MichaelEngstrom/drumming-robot-masters-thesis/media/images/Perkowski_web.jpg

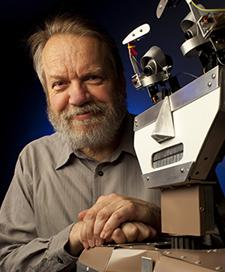
media/images/Perkowski_web.jpg
