MichaelEngstrom/drumming-robot-masters-thesis/media/images/RobotDrum.png

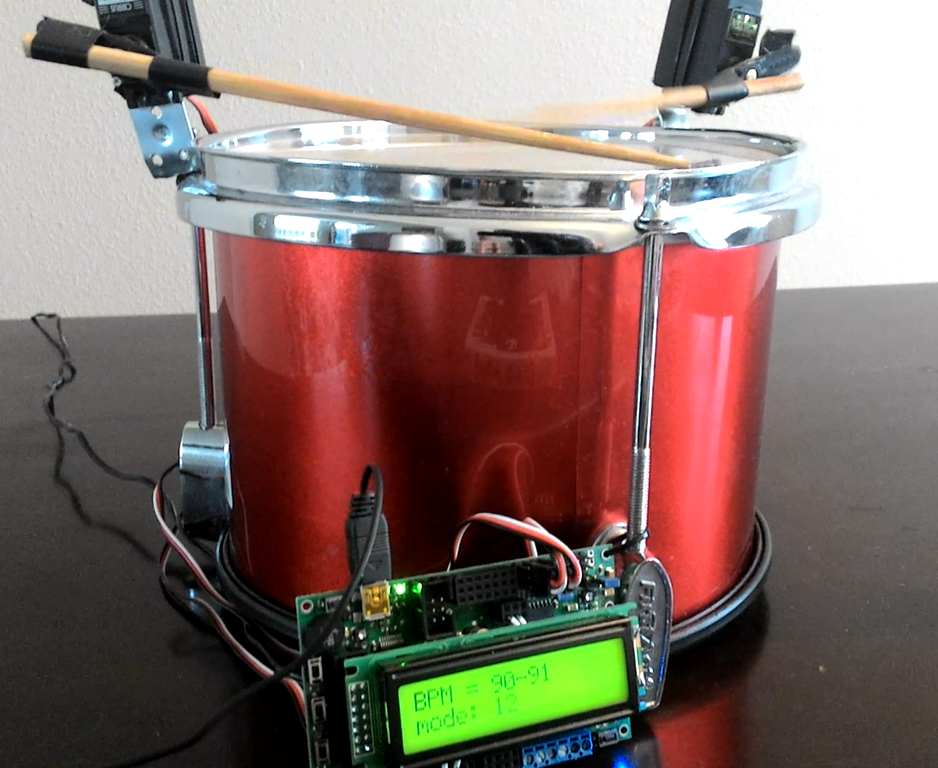
media/images/RobotDrum.png
