MichaelEngstrom/drumming-robot-masters-thesis/README.md

# masters-thesis
Thesis paper and supporting documents, videos, etcetera
