MichaelEngstrom/drumming-robot-masters-thesis/media/The Drumming Robot.pptx

## The Drumming Robot

Michael Engstrom
~
ECE 579 – Winter 2013

## Adding to ‘DIM’ Robot

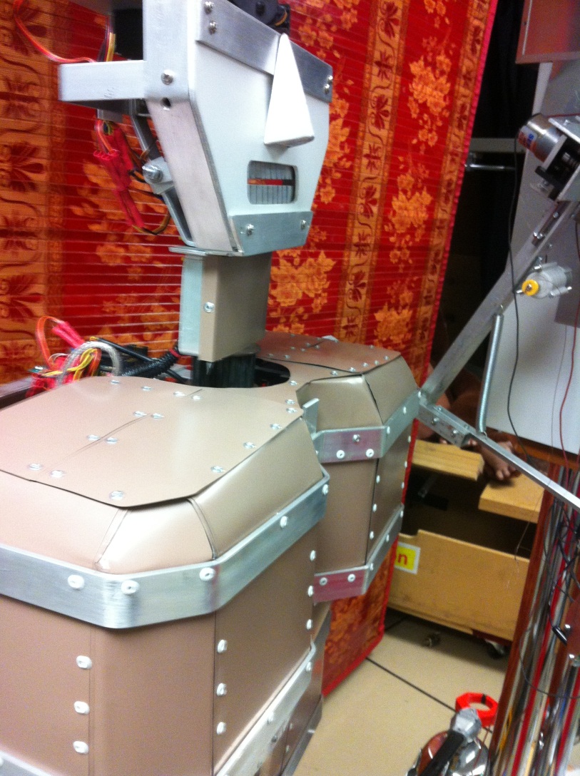
[picture p3: figure]

## Project Idea

- Design a robot that will play drums in rhythm to an audio source which is detected in the environment
- A robot control board will move servos to make arms and legs pound drums to a beat
- An input device will detect the audio, extract the beat, and send the information to the robot controller

## Project Phases

- Mechanical design of robot
  - Arms and legs to beat drums
  - Interface to control software
- Software
  - Input of audio source
  - Beat detection
  - Output to robot controller

## Mechanical Design

- Add limbs to the DIM robot (as seen in the Robot Theater window)
- Use servos to move limbs
- A Pololu ‘Orangutan SVP’ robot controller will handle the servo movement

## The Pololu Orangutan SVP Servo Controller

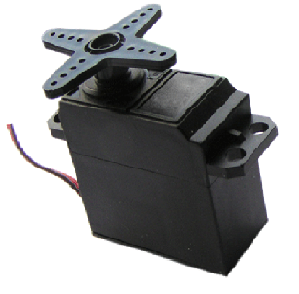
[picture p4: figure]

## Orangutan SVP from Pololu

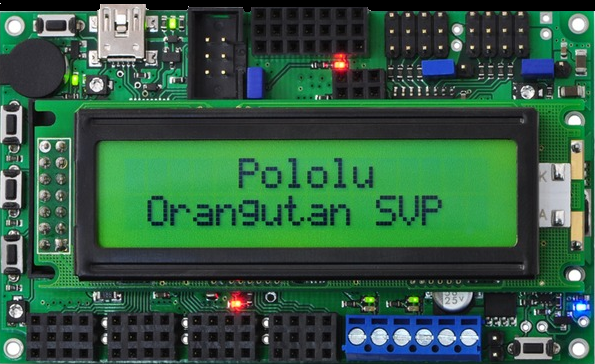
[picture p5: figure]

## Orangutan Specifications

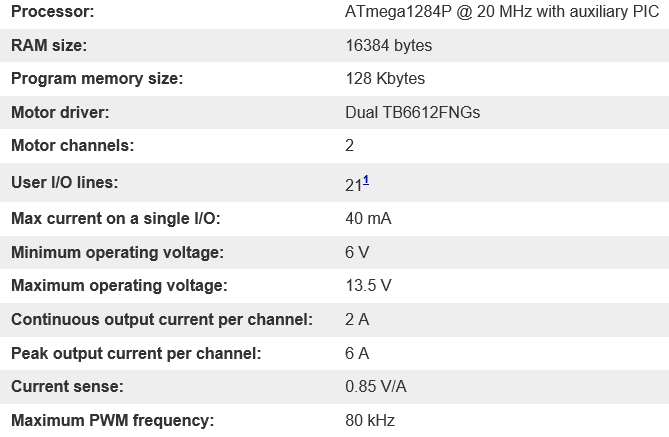
[picture p6: figure]

## DIM’s Torso and Arm

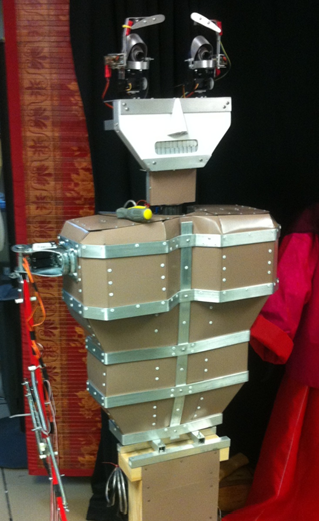
[picture p7: figure]

## Software Design

- Beat Detection Algorithm
  - Rice University Project
  - Based on an MIT design
  - Uses MATLAB to extract beat information from audio input
- Serial interface to Orangutan board
  - BPM and control information

## Beat Detection

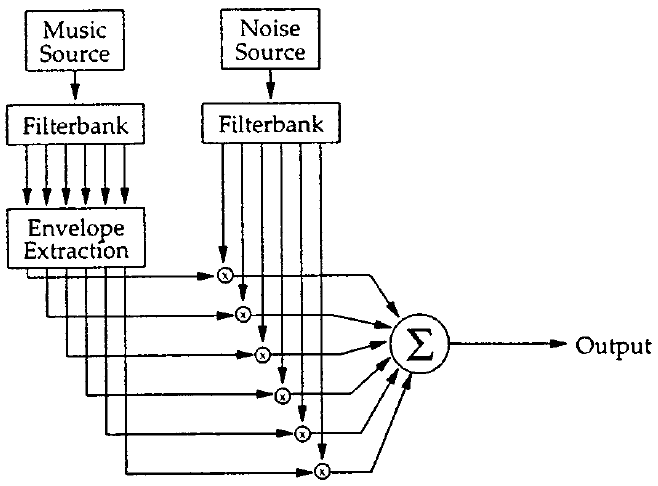
[picture p8: figure]

## PSYCHOACOUSTIC SIMPLIFICATION

- Simplification of Noise sources

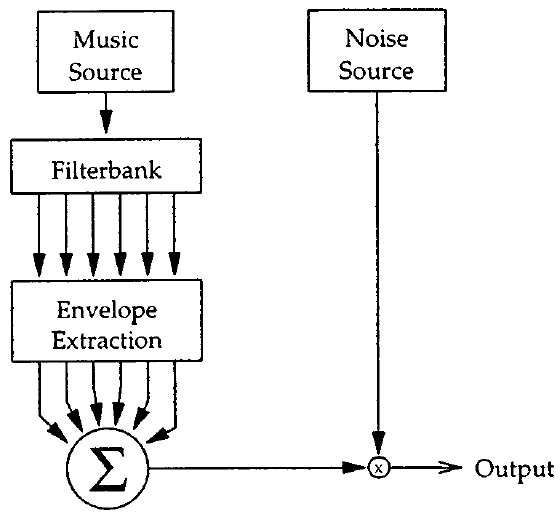
[picture p9: figure]

## Slide 13

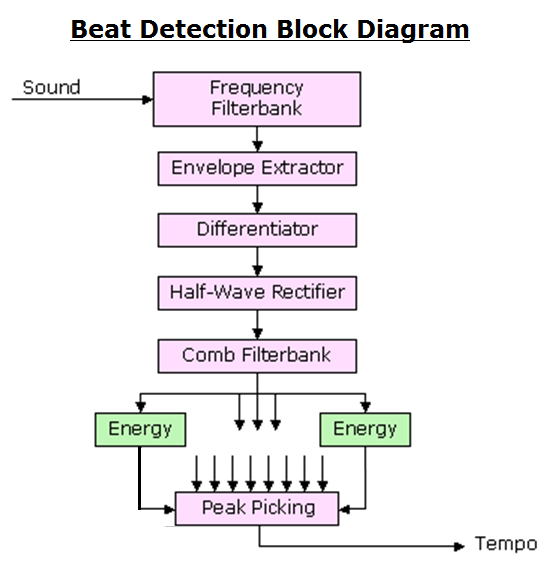
[picture p10: figure]

## Beat Detection Algorithm

- Step 1 – Frequency Filterbank
  - Split audio file into several frequency ranges
    - Similar instrument ranges can inhibit the detection of the beat
  - Allows for different instruments to be detected
    - 0-200Hz, 200-400Hz, 400-800Hz, 800-1600Hz, 1600-3200Hz

## Beat Detection Algorithm

- Step 1 – Frequency Filterbank
- Each filter is implemented using a sixth-order elliptic filter
  - 3 dB of ripple in the passband
  - 40 dB of rejection in the stopband.

## Beat Detection Algorithm

- Step 1 – Frequency Filterbank

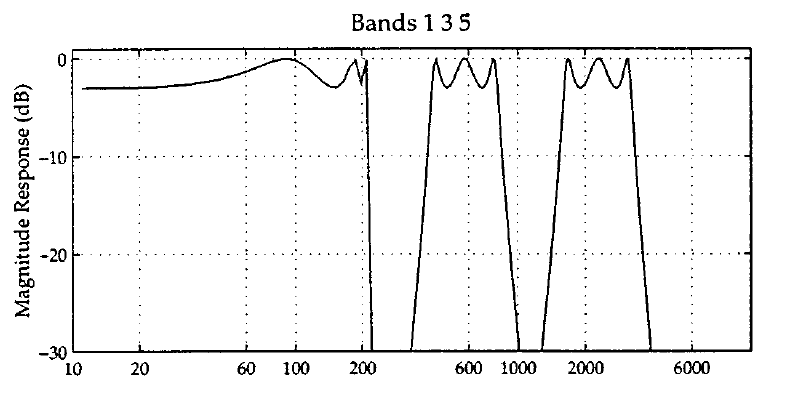
[picture p11: figure]

## Beat Detection Algorithm

- Step 1 – Frequency Filterbank

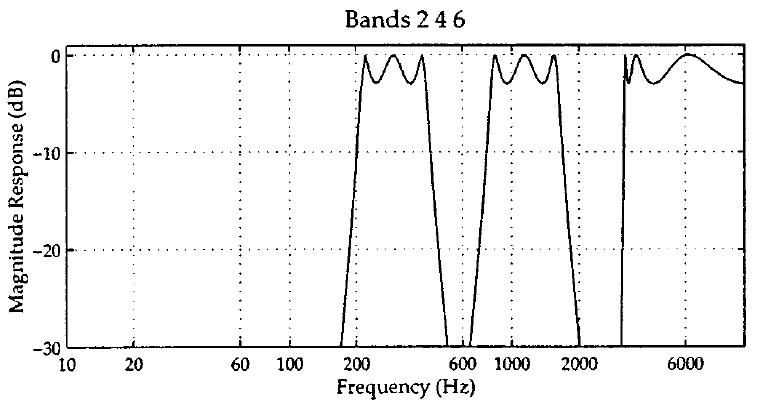
[picture p12: figure]

## Beat Detection Algorithm

- Step 2 – Envelope Smoothing
  - Low-Pass Filter each of the signal segments
    - Convert to Frequency Domain
    - Convolve and transform signal
  - Allows for detection of sudden changes in audio content

## Beat Detection Algorithm

- Step 2 – Envelope Smoothing: Example

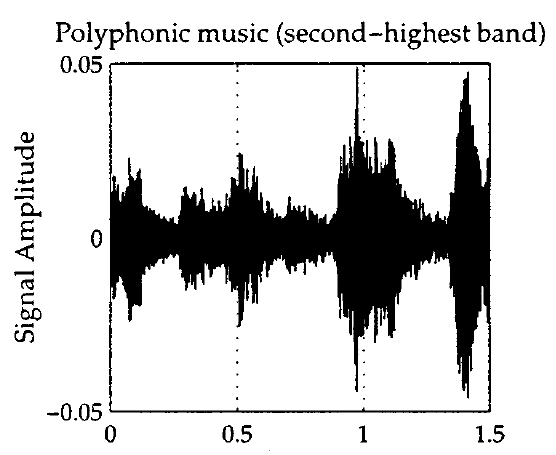
[picture p13: figure]

## Beat Detection Algorithm

- Step 2 – Envelope Smoothing: Example

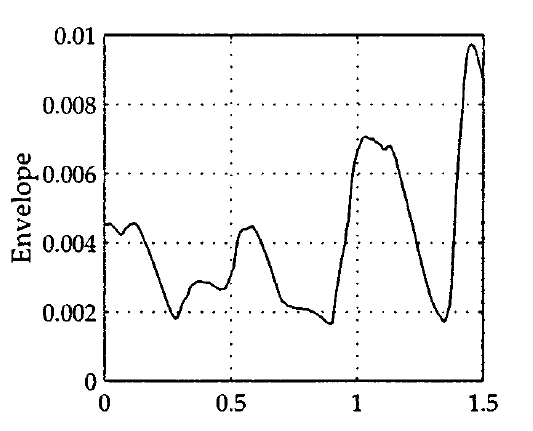
[picture p14: figure]

## Beat Detection Algorithm

- Step 3 – Differentiate signal
  - Accentuate when the sound changes
  - Corresponds to beats
- Step 4 – Rectify signal
  - Only see changes in sound
  - Signals ready to be analyzed

## Beat Detection Algorithm

- Step 5 – Comb Filter
  - Use various filters
  - Determine which has highest energy
  - Maximum value is the fundamental tempo

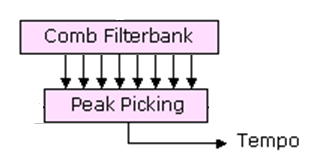
[picture p15: figure]

## Beat Detection Algorithm

- A Comb Filter is used to find tempo maxima
  - For delay T and gain α the magnitude response is
- Local maxima are wherever αe^(−jωT) is near 1 at the Tth roots of unity, expressed as

## Beat Detection Algorithm

- Stimulate a comb filter with delay T and gain α with a right-sided pulse train of height A and period k
- We get reinforcement (resonance) if T=k .
- Let x_t and y_t be the input and output signals at time t
- then y_t = αy_(t−T) + (1-α) x_t

## Beat Detection Algorithm

- Energy is higher at dominant tempos

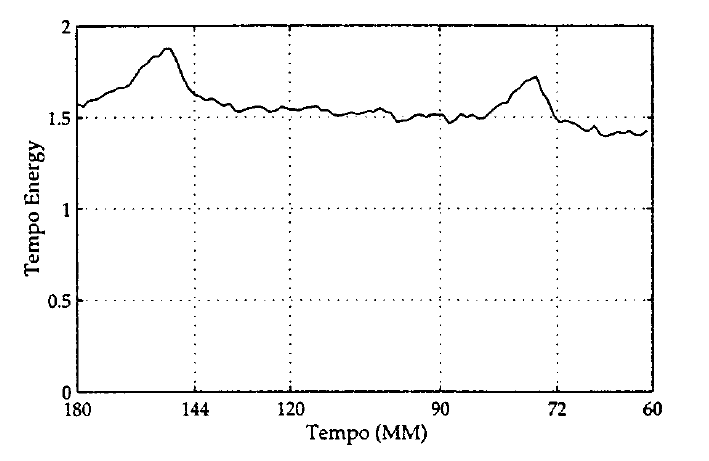
[picture p16: figure]

## Implementing in MATLAB

- Input audio from .wav file or microphone
  - Extract BPM information
    - Algorithm described previously
- Send data to Orangutan robot controller
  - Serial interface between host and controller
  - Change speed and tempo of robot drumming arms according to inputs

## MATLAB Plots

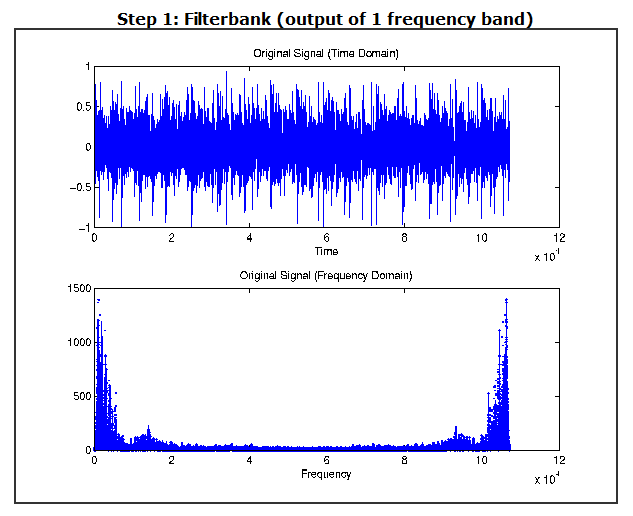
[picture p17: figure]

## Smoothing Plot

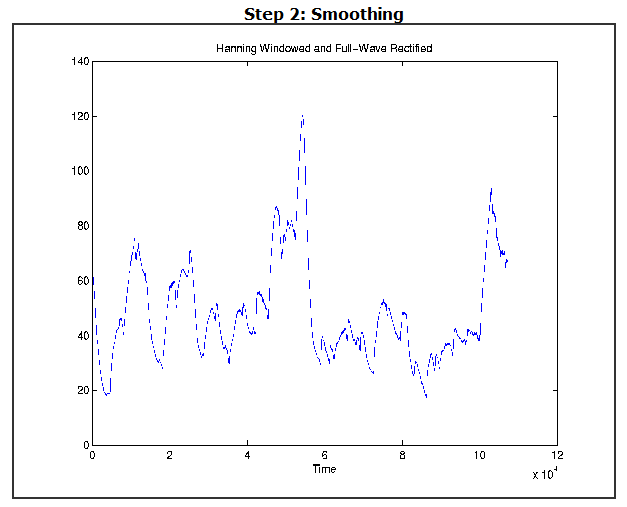
[picture p18: figure]

## Differentiate and Rectify

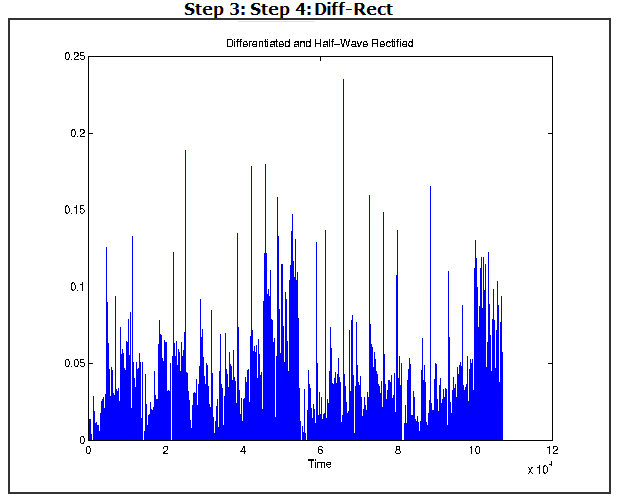
[picture p19: figure]

## Comb Filter

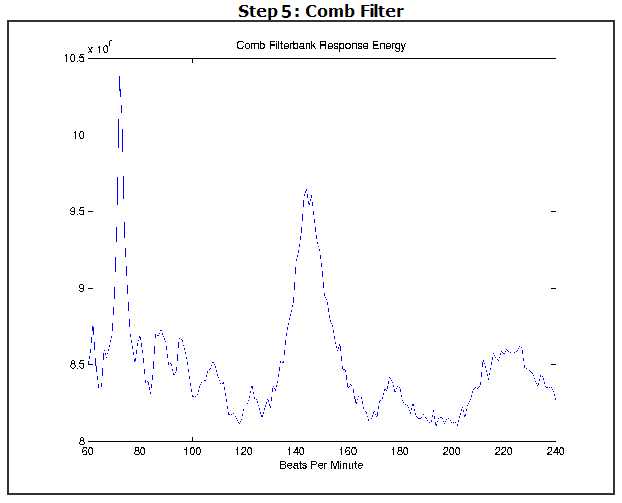
[picture p20: figure]

## The Drumming Robot

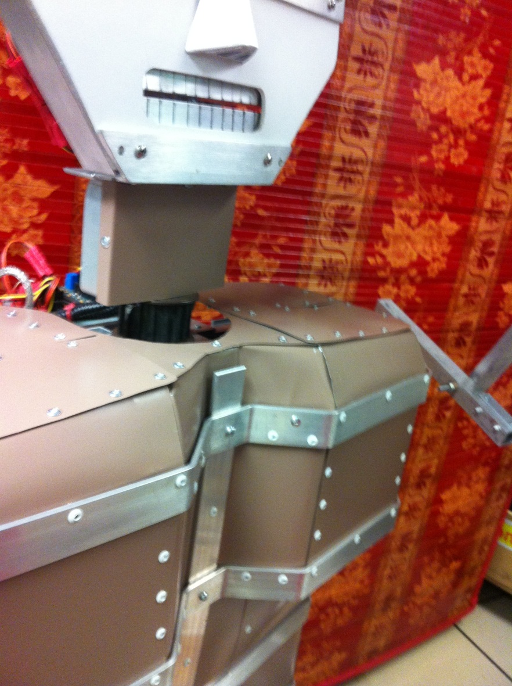
[picture p21: figure]

## References

- Balanço: The Contour of Relative Offbeatness
  - Mehmet Vurkaç - 2012
- Beat Sync Project – Rice University 2001
  - http (http://www.clear.rice.edu/elec301/Projects01/beat_sync/)://www.clear.rice.edu/elec301/Projects01/beat_sync/ (http://www.clear.rice.edu/elec301/Projects01/beat_sync/)
- Pololu Robotics and Electronics
  - http://www.pololu.com
