MichaelEngstrom/drumming-robot-masters-thesis/reference documents/Witte_Sampling.pdf

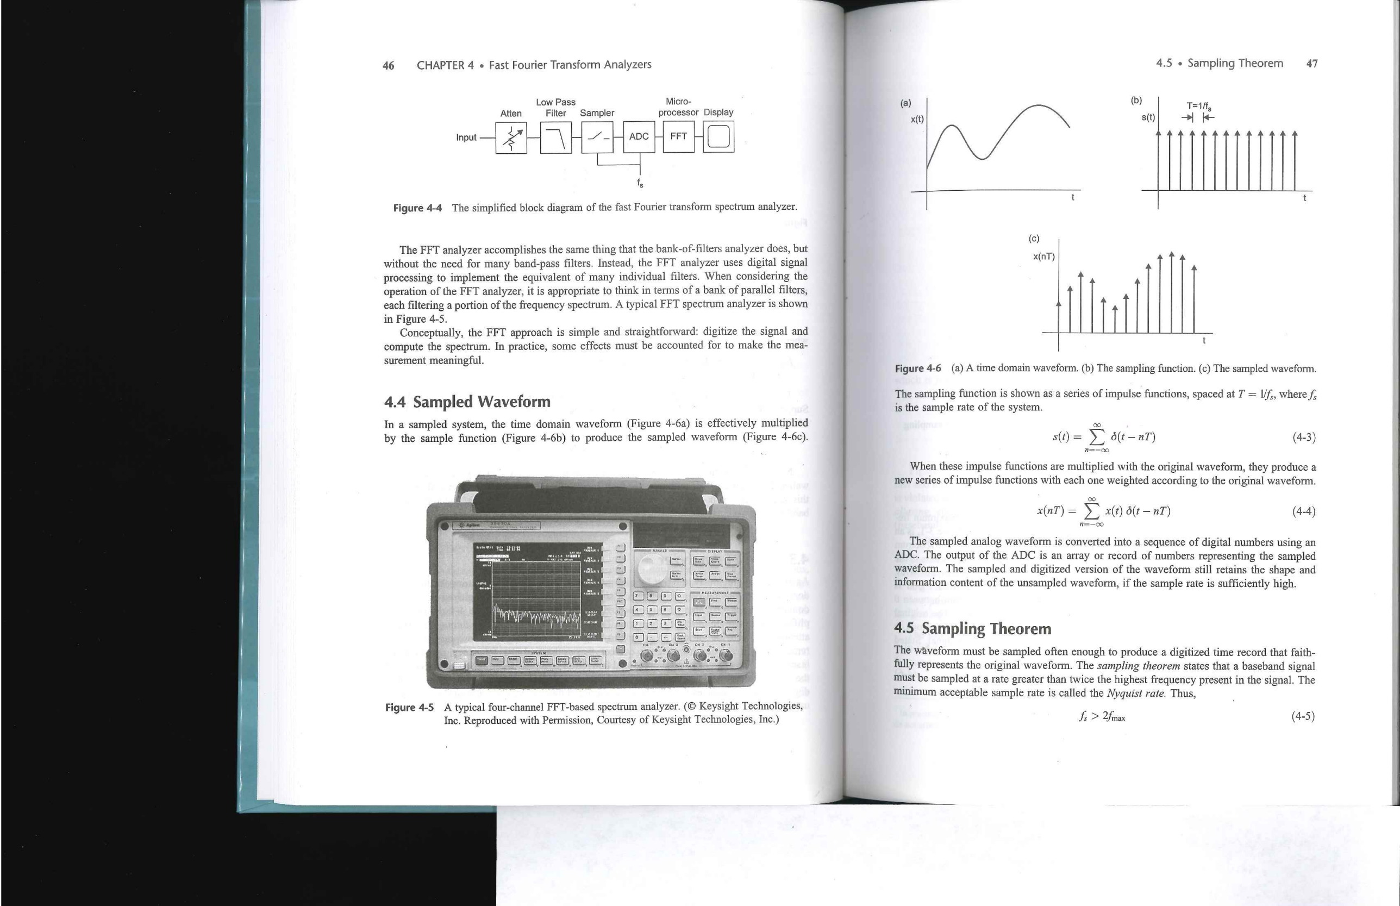
[picture p56: page 1]
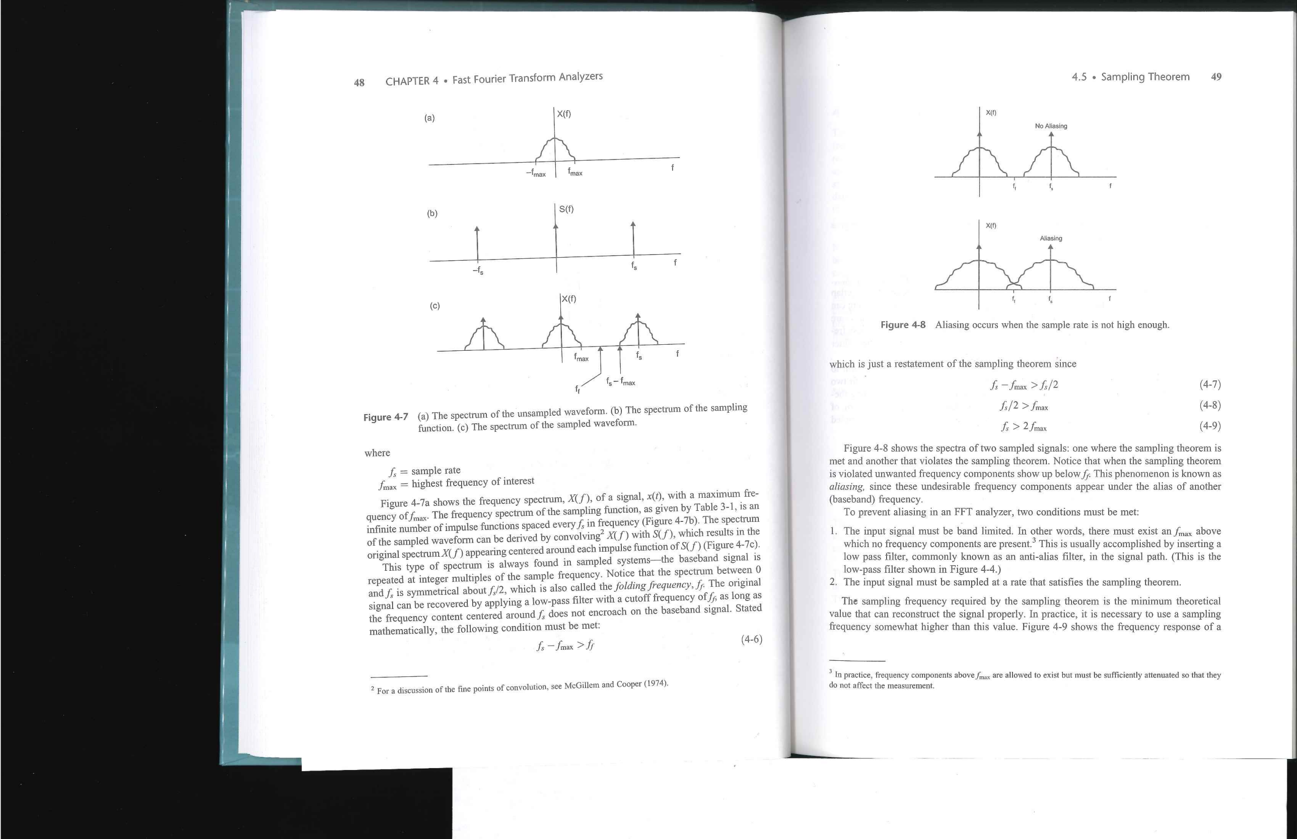
[picture p57: page 2]
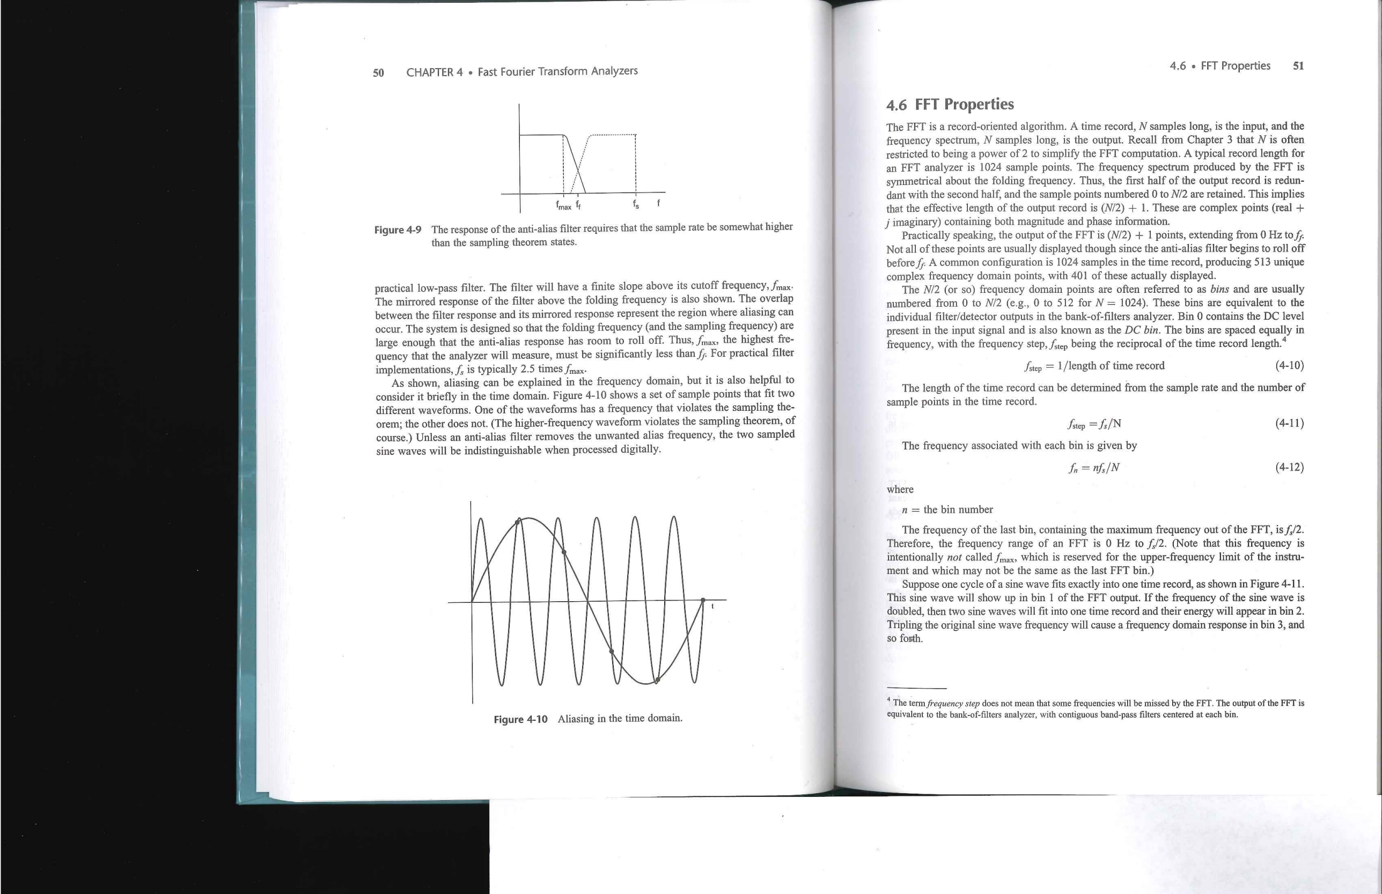
[picture p58: page 3]
