MichaelEngstrom/drumming-robot-masters-thesis/Masters Thesis Tasks.xlsx

Task | Compare my results with Paper | Compare 0-9 vs a-y granularity | Include code for both granularity solutions | References for existing and new data | Background of Fourier and how I use it in project | Explain Algorithm better (and cut out extraneous bits) | Schedule Committee | MATLAB install | Fix serial errors
Progress |  |  |  |  |  |  |  | Sent request to service desk | SerBEAT = serial(str); %<--change this appropriately
 |  |  |  |  |  |  |  | Request timed out, need to resubmit | set(SerBEAT,'BaudRate', 9600, 'DataBits', 8, 'Parity', 'none','StopBits', 1, 'FlowControl', 'none');
 |  |  |  |  |  |  |  | Resubmitted, was upgraded to 2008b | fopen(SerBEAT); %--open the serial port to the PIC
 |  |  |  |  |  |  |  | Project runs, Serial comm issues | NOTE: try using 'serial' call with static members. Ex:
 |  |  |  |  |  |  |  |  | s = serial('COM1','baudrate',4800); OR: s2 = serial('COM2','BaudRate',1200,'DataBits',7);
 |  |  |  |  |  |  |  |  | query for member values:
 |  |  |  |  |  |  |  |  | get(s1,{'Type','Name','Port'})
 |  |  |  |  |  |  |  |  | ans =
 |  |  |  |  |  |  |  |  | 'serial' 'Serial-COM1' 'COM1'
 |  |  |  |  |  |  |  |  | UPDATE: fixed by using
 |  |  |  |  |  |  |  |  | upper(COM Port String)
 |  |  |  |  |  |  |  |  | to make string capitals. Don't ask why it needs it, just accept it.
