MichaelEngstrom/drumming-robot-masters-thesis/Beat This - Rice University/Beat This _ Background_files/BadBlockDiag.gif

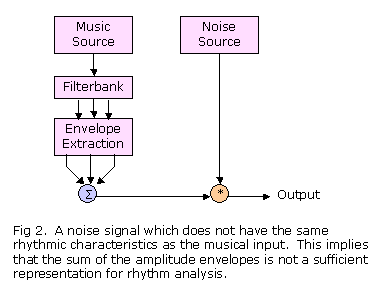
Beat This - Rice University/Beat This _ Background_files/BadBlockDiag.gif
