MichaelEngstrom/drumming-robot-masters-thesis/Beat This - Rice University/Beat This _ Beat Detection Algorithm_files/plot4_small.gif

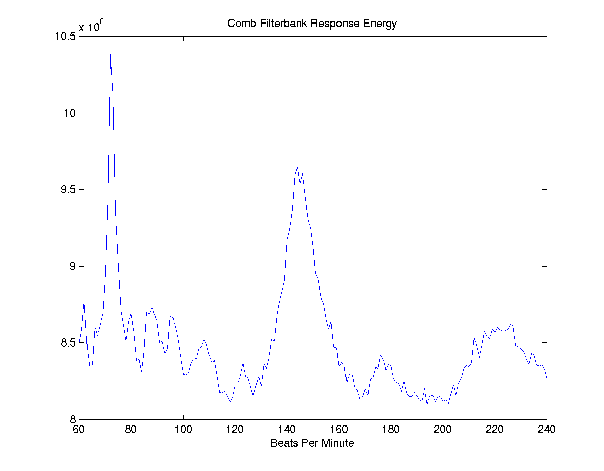
Beat This - Rice University/Beat This _ Beat Detection Algorithm_files/plot4_small.gif
