MichaelEngstrom/drumming-robot-masters-thesis/Beat This - Rice University/Beat This _ Phase Alignment Algorithm_files/plot6_small.gif

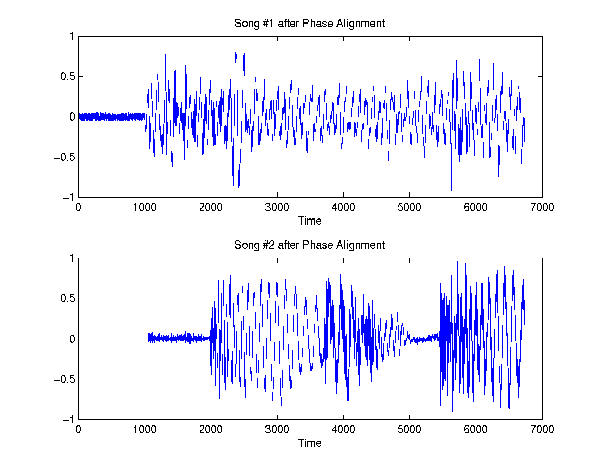
Beat This - Rice University/Beat This _ Phase Alignment Algorithm_files/plot6_small.gif
