MichaelEngstrom/drumming-robot-masters-thesis/figures and tables/InputSignal_HammingWindow.png

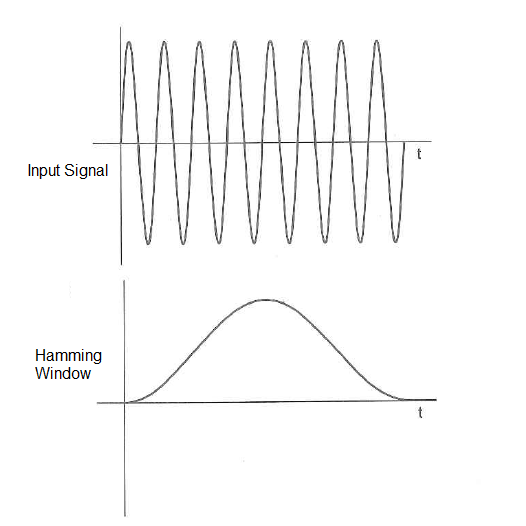
figures and tables/InputSignal_HammingWindow.png
