MichaelEngstrom/drumming-robot-masters-thesis/figures and tables/SignalAfterHammingApplied.png

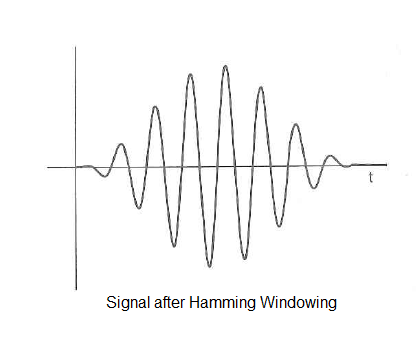
figures and tables/SignalAfterHammingApplied.png
