MichaelEngstrom/drumming-robot-masters-thesis/media/images/DiffRect.png

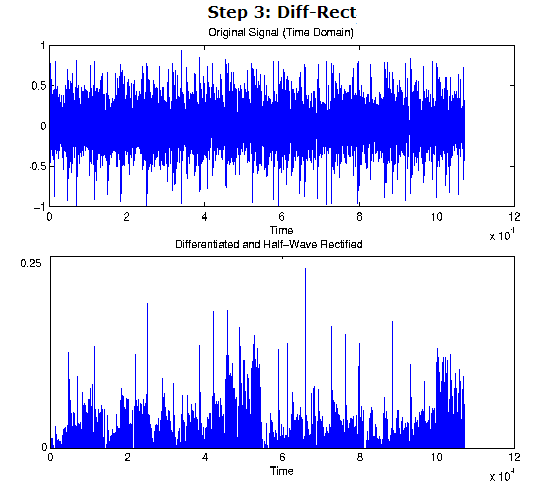
media/images/DiffRect.png
