MichaelEngstrom/drumming-robot-masters-thesis/media/images/RubberCaster.jpg

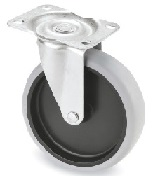
media/images/RubberCaster.jpg
