MichaelEngstrom/drumming-robot-masters-thesis/media/images/SwingArmLamp.jpg

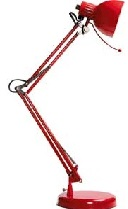
media/images/SwingArmLamp.jpg
