MichaelEngstrom/drumming-robot-masters-thesis/media/images/TowerProMG995.jpg

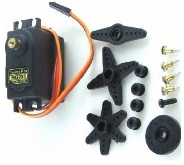
media/images/TowerProMG995.jpg
