MichaelEngstrom/drumming-robot-masters-thesis/figures and tables/RiceMusicResults.png

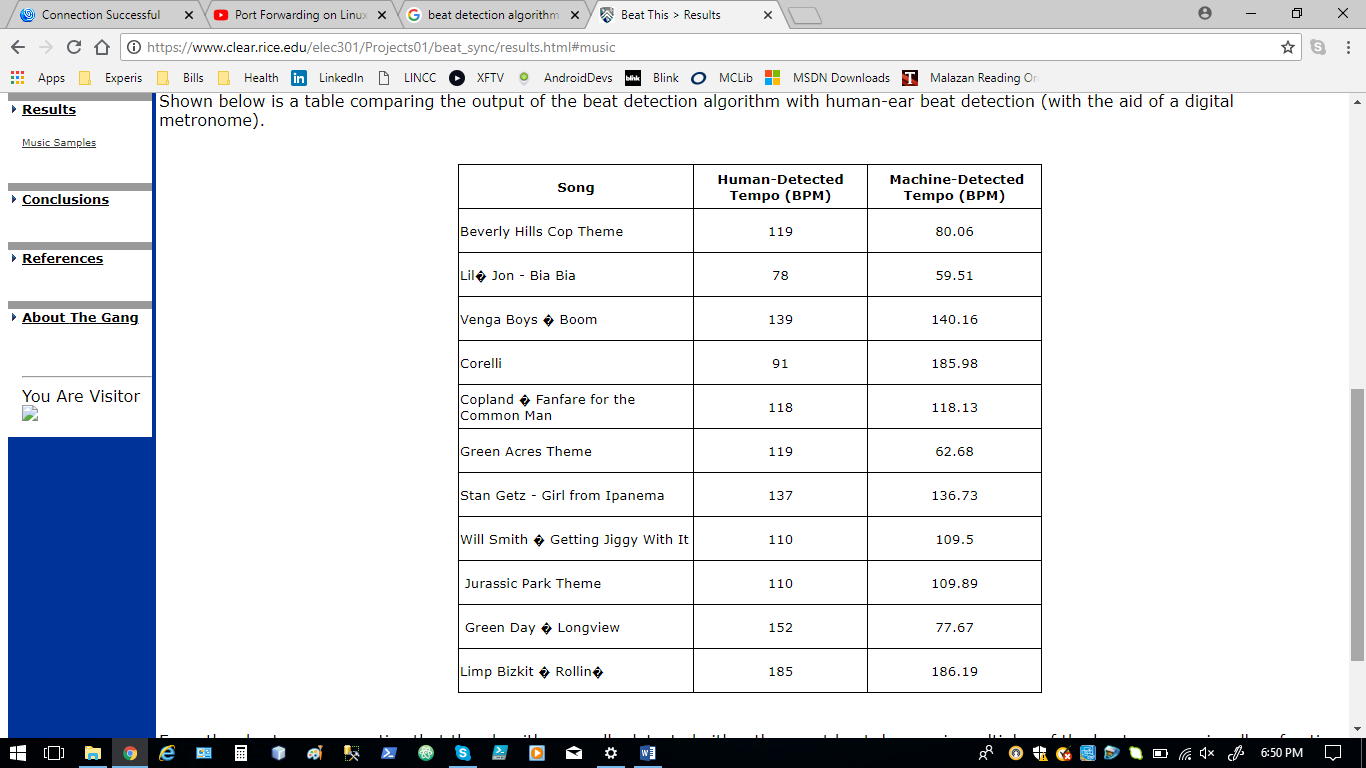
figures and tables/RiceMusicResults.png
