MichaelEngstrom/drumming-robot-masters-thesis/figures and tables/RiceMusicResultsCropped.png

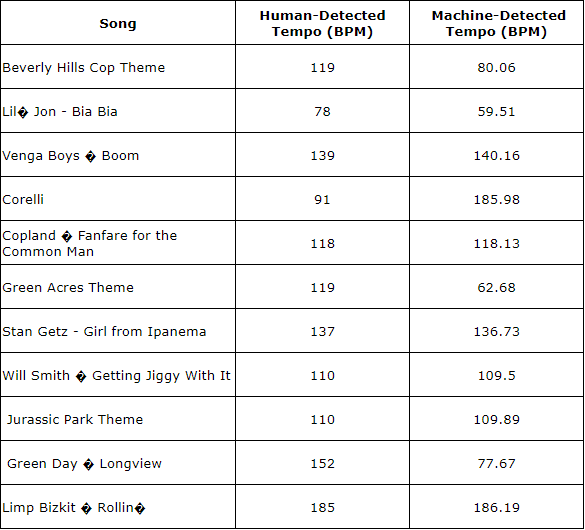
figures and tables/RiceMusicResultsCropped.png
