MichaelEngstrom/drumming-robot-masters-thesis/FINAL_INPUT_FOR_CHANGES_TO_THESIS.txt

More clearly (and short) explain my contribution
Innovation
Contribution to knowledge
Little bit in introduction and some in conclusion
Comparison to existing literature
