MichaelEngstrom/drumming-robot-masters-thesis/atmel  info/org06a02_schematic.pdf

# Orangutan SVP Schematic Diagram

# Primary Microcontroller Connections

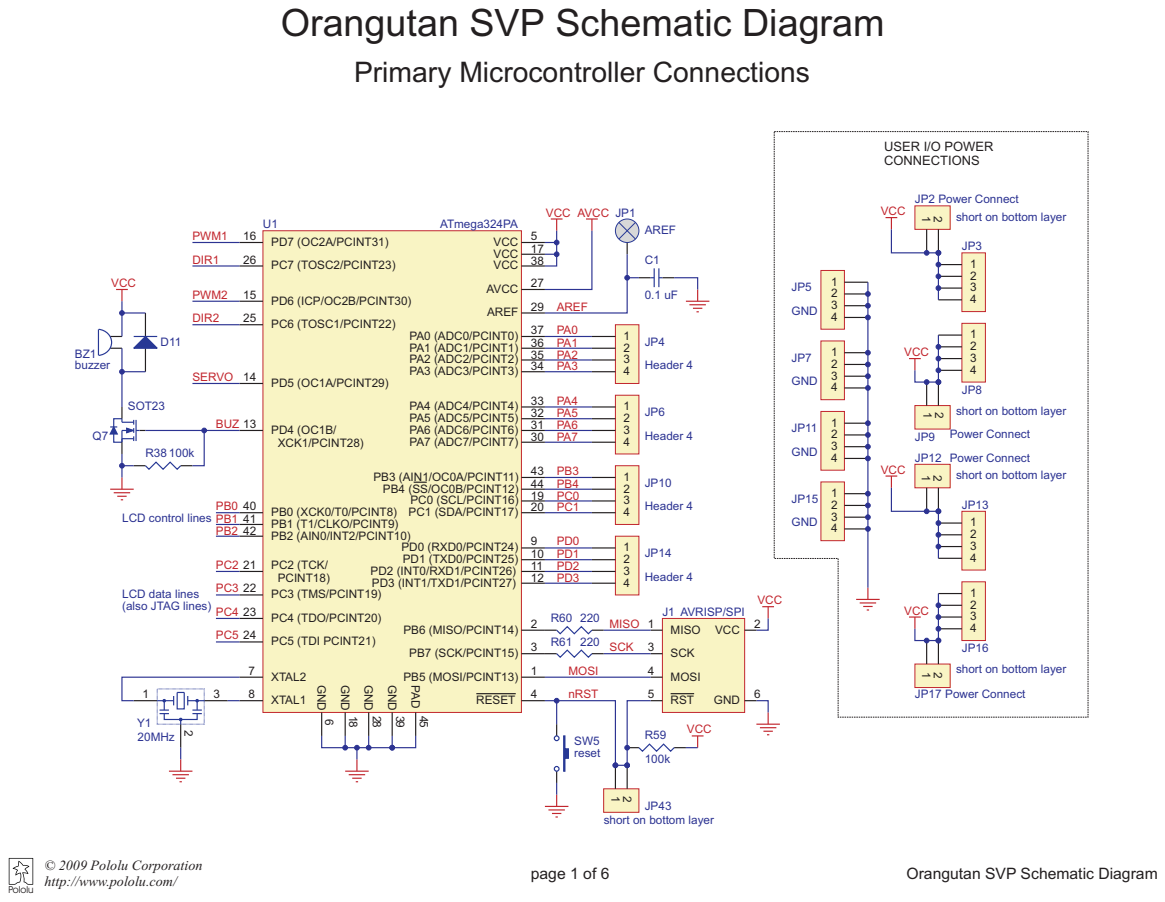
[picture p75: page 1]

short on bottom layer

# Motor Drive and Current Sensing

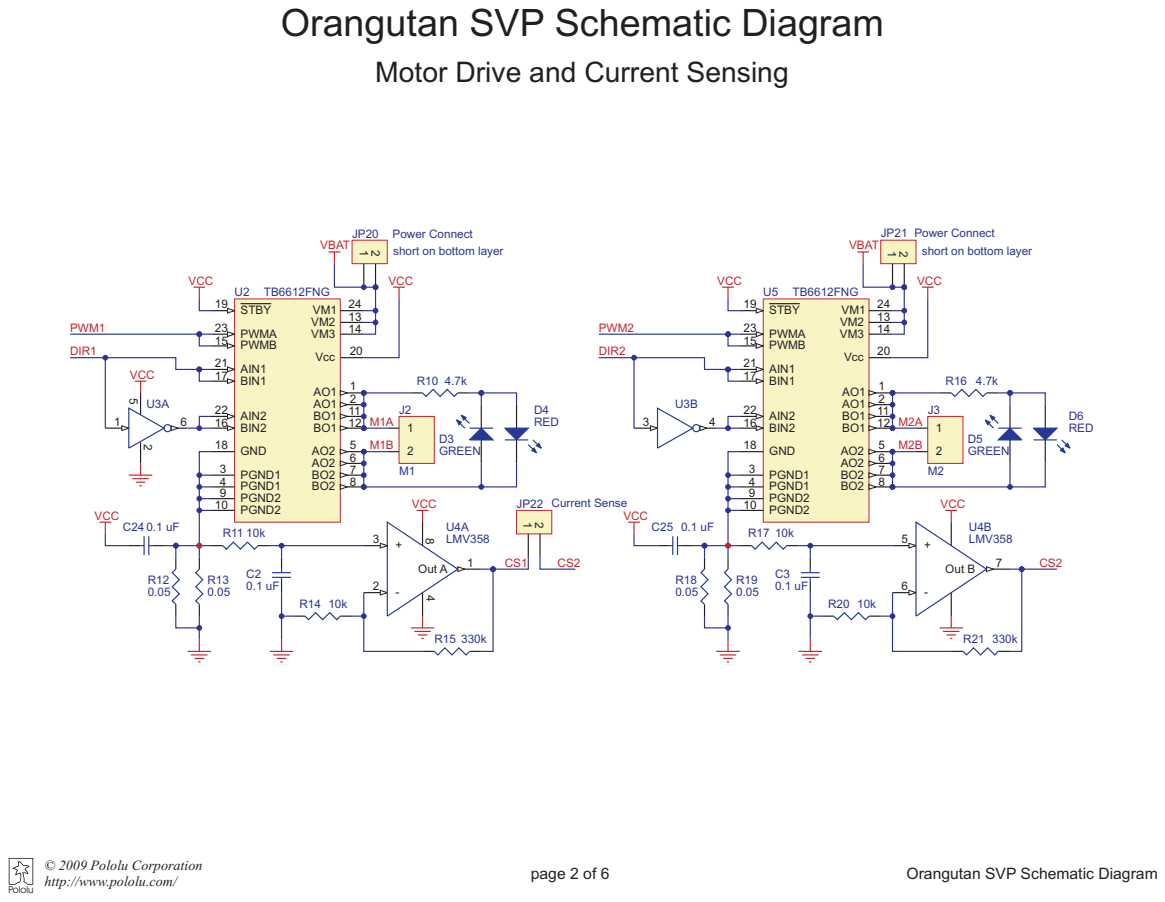
[picture p76: page 2]

short on bottom layer

# Servo Control and Adjustable Buck Regulator

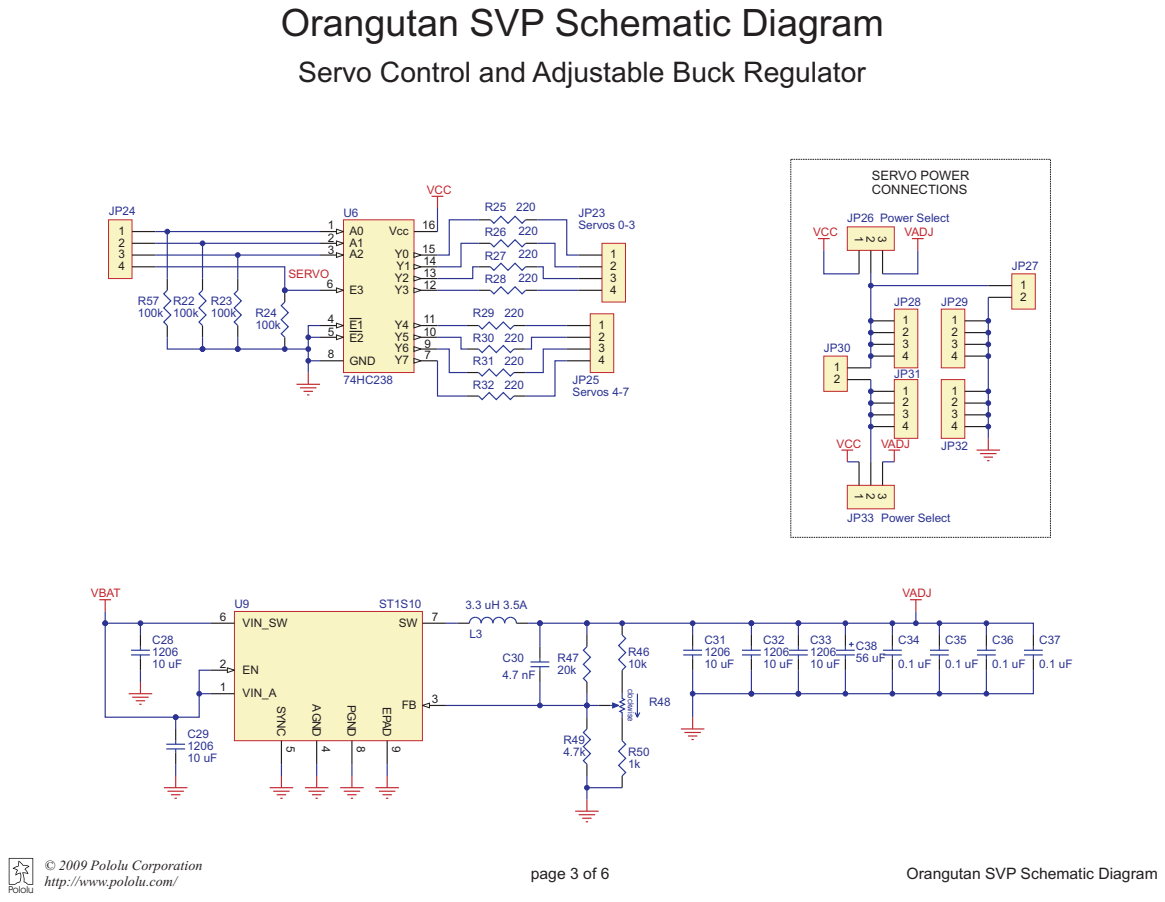
[picture p77: page 3]

# LCD, LEDs, and Pushbuttons

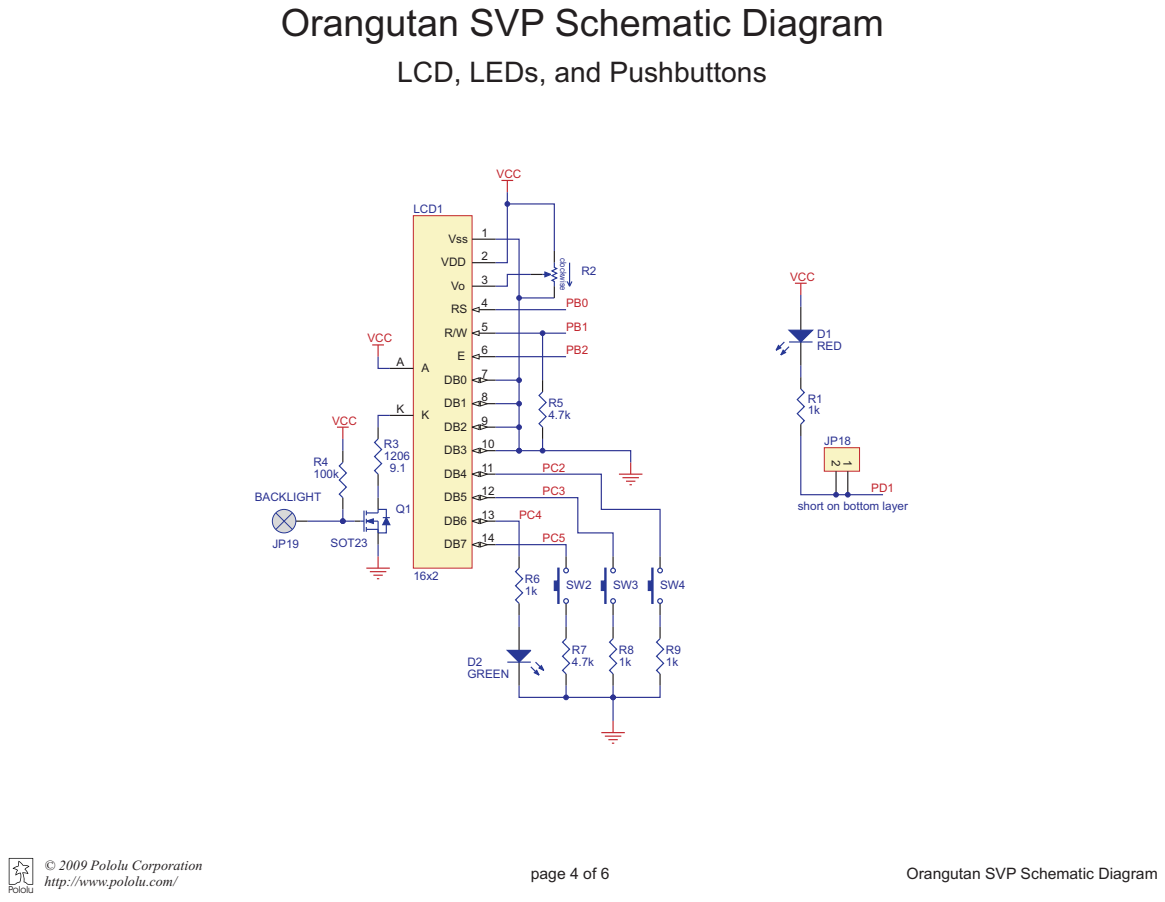
[picture p78: page 4]

short on bottom layer

# Auxiliary Microcontroller and USB

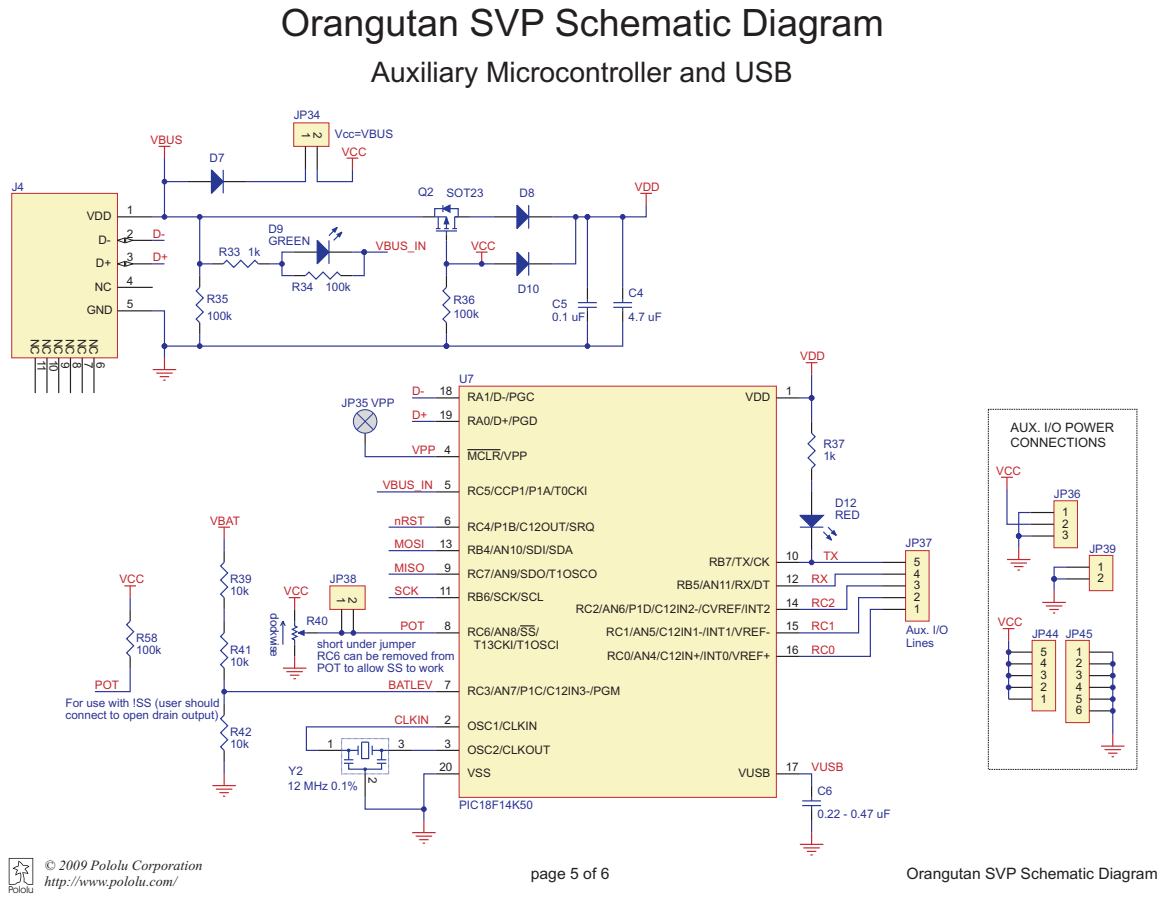
[picture p79: page 5]

short under jumper
RC6 can be removed from
POT to allow SS to work

POT
For use with !SS (user should
connect to open drain output)

# Main Power and 5V Buck Regulator

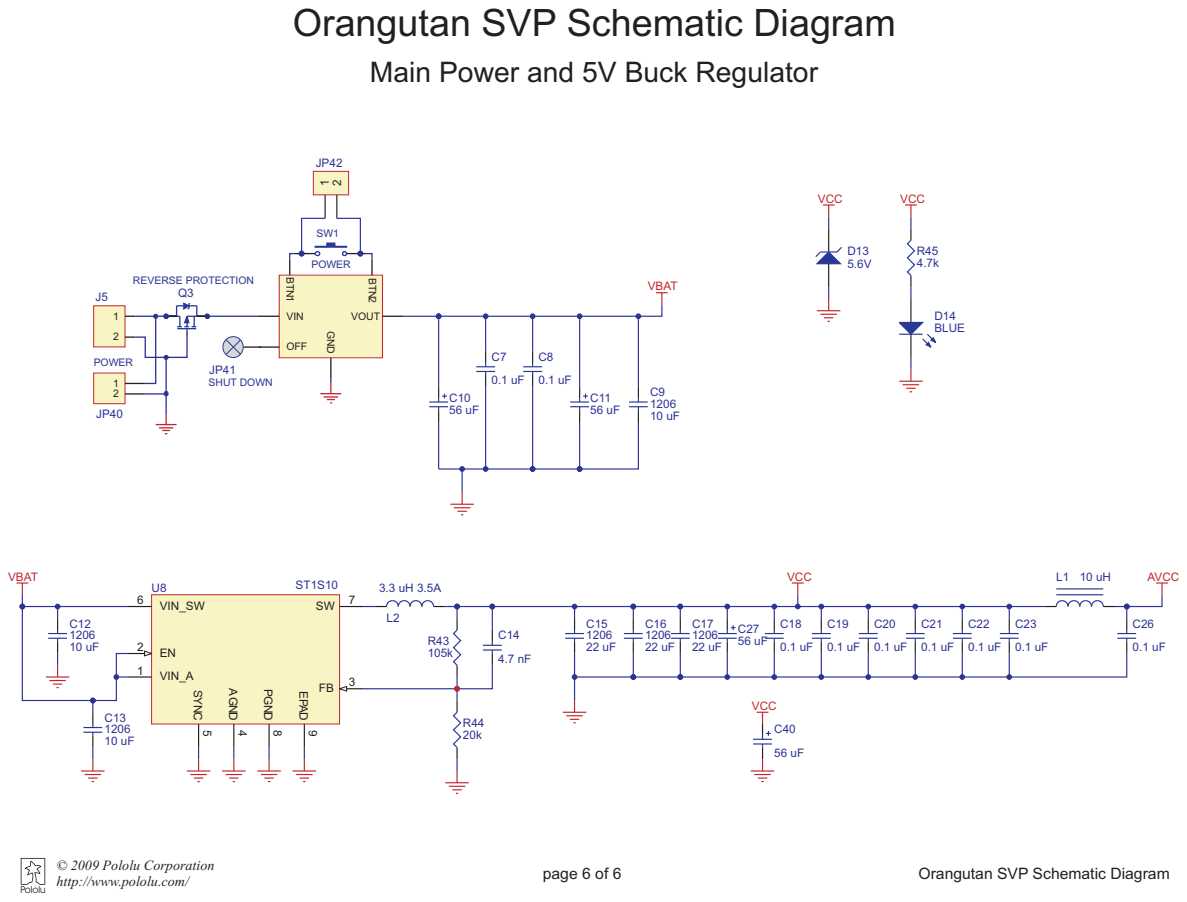
[picture p80: page 6]
