MichaelEngstrom/drumming-robot-masters-thesis/figures and tables/UpdatedRobotControllerStateMachine3.pdf

a | b | c | d
| | | e

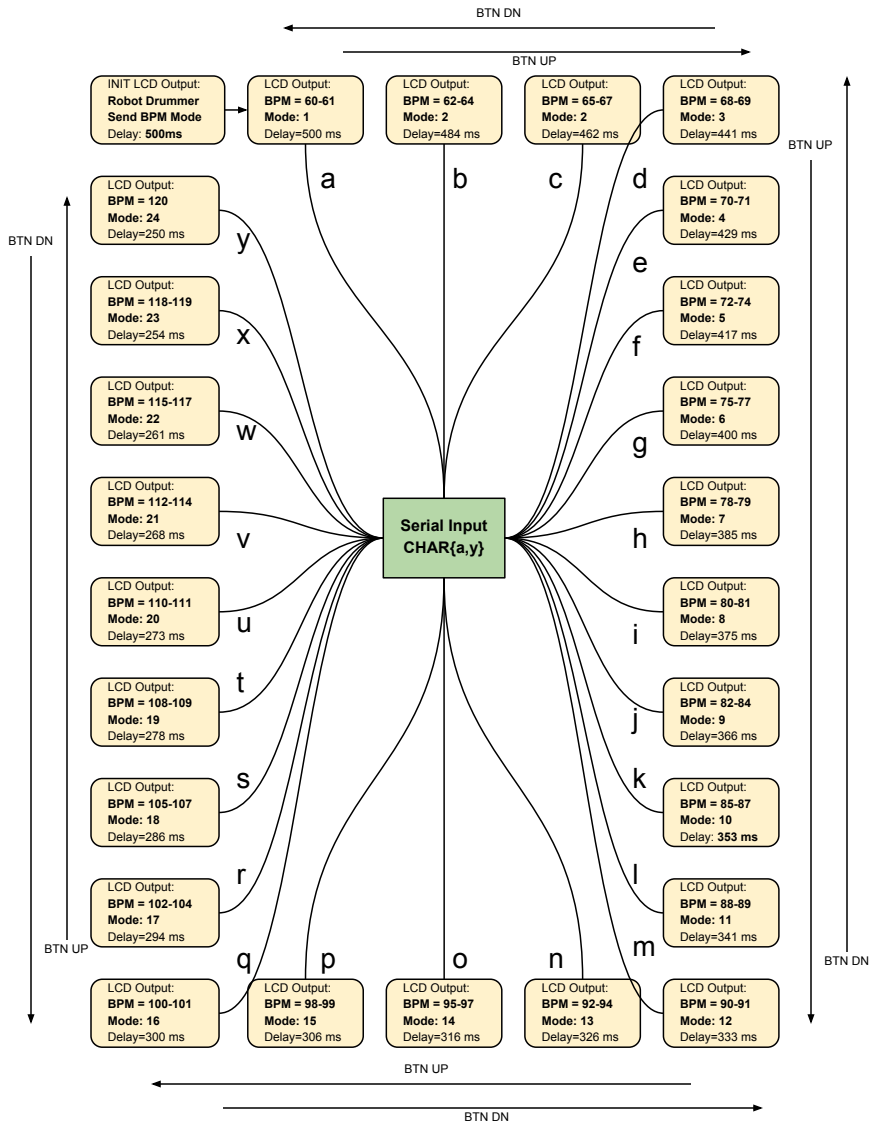
[picture p81: page 1]
LCD Output:; BPM = 70-71; Mode: 4; Delay=429 ms; BPM = 72-74; Mode: 5 Delay=417 ms; BPM = 75-77 Mode: 6; Delay=400 ms; BPM = 78-79; Mode: 7 Delay=385 ms; BPM = 80-81; Mode: 8 Delay=375 ms; BPM = 82-84; Mode: 9; Delay=366 ms; BPM = 85-87; Mode: 10; Delay: 353 ms; BPM = 88-89; Mode: 11; Delay=341 ms; BPM = 120; Mode: 24; Delay=250 ms; BPM = 118-119; Mode: 23; Delay=254 ms; BPM = 115-117; Mode: 22; Delay=261 ms; BPM = 112-114; Mode: 21; Delay=268 ms; BPM = 110-111; Mode: 20 Delay=273 ms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

INIT LCD Output:
Robot Drummer
Send BPM Mode
Delay: 500ms
