MichaelEngstrom/drumming-robot-masters-thesis/(commit log)

2017-01-27 Add files via upload
    Matlab files, thesis document, videos of robot drum, optimization test results, Visio diagrams
    [BOM.xlsx, Optimization.xlsx]
2017-05-15 Added higher resolution drum vids to see LCD better
    Used Movie Maker to edit robot drum vids to be under the 25MB limit, and
    sharpen the LCD resolution. Achieved by a Black and White filter.
2017-09-12 Noted MATLAB support timeout
    Tried to install MATLAB on home laptop, failed, sent support request to
    Mathworks which timed out. Need to reinstall and resubmit support
    request.
    [Masters Thesis Tasks.xlsx]
2017-11-17 Work at Starbucks on MLK
    [Masters Thesis Tasks.xlsx, Optimization.xlsx]
2017-11-20 Added pdfs and controller descriptions
    Large and Kolen (!) plus Povel and Essens
    Added controller details with function library, board features, project
    examples
2017-12-30 MATLAB serial fix, Orangutan and Atmel info
    Fixed serial errors with MATLAB code, added code to Word document.
    Added Pololu Orangutan and Atmel AVR documentation.
    [Masters Thesis Tasks.xlsx]
2018-01-07 Reinstall Atmel 7 and run program
    Reinstalled Atmel Studio 7 after system restore
    Installed Pololu drivers
    Opened DrummingRobot project
2018-06-11 Robot Controller State Machine I/O
    Added flow chart diagram and input/output list for a-z Robot Controller
    code
    [RobotControllerSystem.xlsx]
2018-07-18 More Windowing info
    Added a couple Windowing figures from Witte and expanded the
    description.
2019-01-10 Rice University results and comparison
    Added Rice University error results and comparison to my results
    Downloaded Rice html pages and code
    [RiceMusicResults.xlsx]
2019-03-14 Added files and organized
    Copied files from flash drive with more reference docs, videos, images.
    Also organized the folders a little bit.
    [BOM.xlsx, Optimization (2).xlsx, Optimization.xlsx, RiceMusicResults.xlsx, RobotControllerSystem.xlsx]
2019-04-18 Modified powerpoint
    Deleted and added slides to ppt
2019-04-25 Powerpoint improvements
    Added many slides clarified others for upcoming Thesis Defense.
2019-09-24 Formatting continued
    Abstract header font 14 => 12
    Abstract spacing => 2.0
    TOC font 11 => 12
    Main body page number formatting to match title sample
    Body headers font => 12
2019-09-24 Final Word and PDF
    Some final page shifting for formatting. Couple of images reworked for
    width, Excel redone for one.. PDF created.
    [RobotControllerSystem.xlsx]
2019-09-30 Numbering and margins
    Added section break to title page. Seems to have fixed the numbering.
    Now: none for title, roman numerals starting with Abstract, regular
    numbers starting Chapter 1.
    Right margin now 1.1", Left 1.6" and 1" top and bottom.
    All numbers at 1" bottom margin. Moved to right per suggestion.
    Fixed Figure 19 and shortened it to put it on same page as caption.
    [RobotControllerSystem.xlsx]
